puer/efan/EFan.kicad_pcb

## KiCad design EFan.kicad_pcb (2019-11-07)

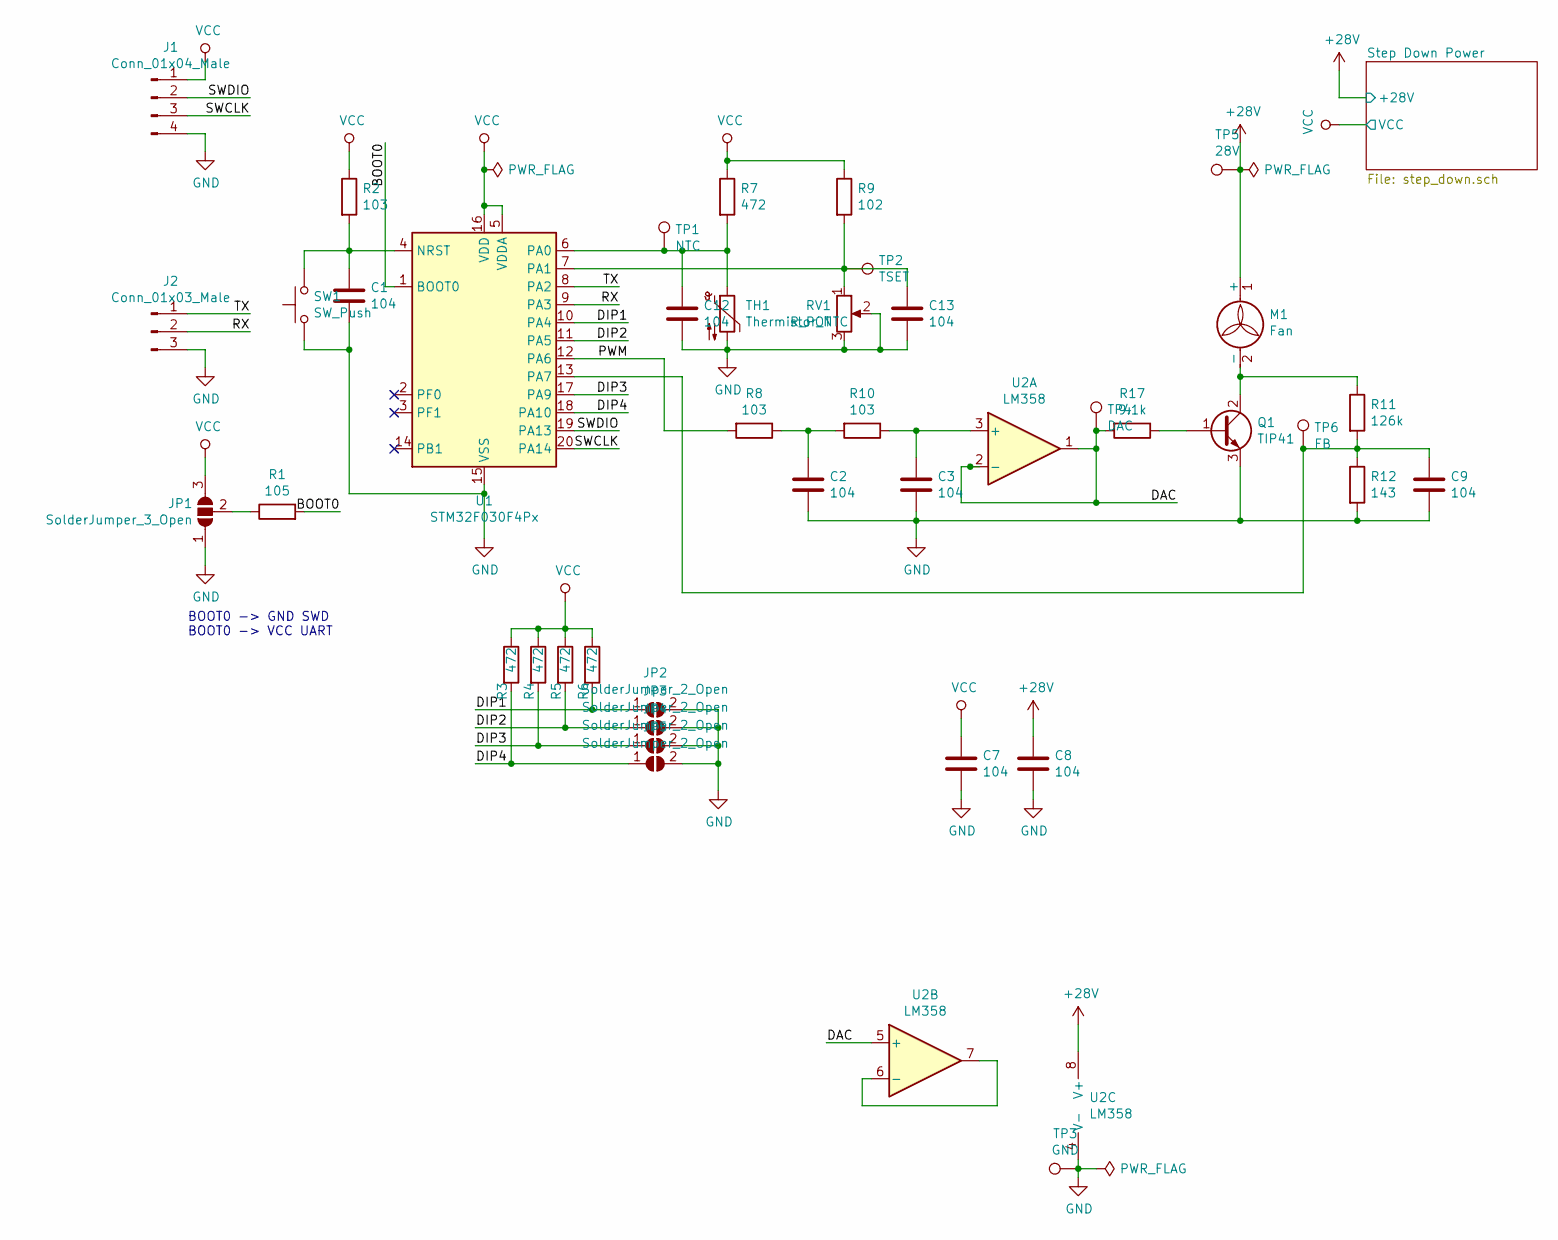
[picture p1: schematic EFan.sch]

Parts:
C1, C2, C3, C7, C8, C9, C12, C13: 104; C_0603_1608Metric_Pad1.05x0.95mm_HandSolder
J1: Conn_01x04_Male; PinHeader_1x04_P2.54mm_Vertical
J2: Conn_01x03_Male; PinHeader_1x03_P2.54mm_Vertical
JP1: SolderJumper_3_Open; SolderJumper-3_P1.3mm_Open_RoundedPad1.0x1.5mm_NumberLabels
JP2, JP3, JP4, JP5: SolderJumper_2_Open; SolderJumper-2_P1.3mm_Open_RoundedPad1.0x1.5mm
M1: Fan; PinHeader_1x02_P2.54mm_Vertical
Q1: TIP41; TO-220-3_Vertical
R1: 105; R_0603_1608Metric_Pad1.05x0.95mm_HandSolder
R2, R8, R10: 103; R_0603_1608Metric_Pad1.05x0.95mm_HandSolder
R3, R4, R5, R6, R7: 472; R_0603_1608Metric_Pad1.05x0.95mm_HandSolder
R9: 102; R_0603_1608Metric_Pad1.05x0.95mm_HandSolder
R11: 126k; R_0603_1608Metric_Pad1.05x0.95mm_HandSolder
R12: 143; R_0603_1608Metric_Pad1.05x0.95mm_HandSolder
R17: 9.1k; R_0603_1608Metric_Pad1.05x0.95mm_HandSolder
RV1: R_POT; Potentiometer_Bourns_3296W_Vertical
SW1: SW_Push; SW_PUSH_6mm
TH1: Thermistor_NTC; PinHeader_1x02_P2.54mm_Vertical
TP1: NTC; TestPoint_Loop_D2.50mm_Drill1.0mm
TP2: TSET; TestPoint_Loop_D2.50mm_Drill1.0mm
TP3: GND; PinHeader_1x01_P2.54mm_Vertical
TP4: DAC; TestPoint_Loop_D2.50mm_Drill1.0mm
TP5: 28V; PinHeader_1x01_P2.54mm_Vertical
TP6: FB; TestPoint_Loop_D2.50mm_Drill1.0mm
U1: STM32F030F4Px; TSSOP-20_4.4x6.5mm_P0.65mm
U2: LM358; DIP-8_W7.62mm

Connections:
+28V: C8.1, M1.1 (+), TP5.1, U2.8 (V+); also elsewhere on the board
/BOOT0: R1.2, U1.1 (BOOT0)
/DAC: R17.2, TP4.1, U2.1, U2.2 (-), U2.5 (+)
/DIP1: JP2.1 (A), R6.2, U1.10 (PA4)
/DIP2: JP3.1 (A), R5.2, U1.11 (PA5)
/DIP3: JP4.1 (A), R4.2, U1.17 (PA9)
/DIP4: JP5.1 (A), R3.2, U1.18 (PA10)
/PWM: R8.2, U1.12 (PA6)
/RX: J2.2, U1.9 (PA3)
/SWCLK: J1.3, U1.20 (PA14)
/SWDIO: J1.2, U1.19 (PA13)
/TX: J2.1, U1.8 (PA2)
GND: C1.2, C2.2, C3.2, C7.2, C8.2, C9.2, C12.2, C13.2, J1.4, J2.3, JP1.1 (A), JP2.2 (B), JP3.2 (B), JP4.2 (B), JP5.2 (B), Q1.3 (E), R12.2, RV1.2, RV1.3, SW1.1, TH1.2, TP3.1, U1.15 (VSS), U2.4 (V-); also elsewhere on the board
unnamed: C1.1, R2.2, SW1.2, U1.4 (NRST)
unnamed: C2.1, R8.1, R10.2
unnamed: C3.1, R10.1, U2.3 (+)
unnamed: C9.1, R11.2, R12.1, TP6.1, U1.13 (PA7)
unnamed: C12.1, R7.2, TH1.1, TP1.1, U1.6 (PA0)
unnamed: C13.1, R9.2, RV1.1, TP2.1, U1.7 (PA1)
unnamed: JP1.2 (C), R1.1
unnamed: M1.2 (-), Q1.2 (C), R11.1
unnamed: Q1.1 (B), R17.1
unnamed: U2.6 (-), U2.7
VCC: C7.1, J1.1, JP1.3 (B), R2.1, R3.1, R4.1, R5.1, R6.1, R7.1, R9.1, U1.5 (VDDA), U1.16 (VDD); also elsewhere on the board

Notes on the sheet:
BOOT0 -> GND SWD BOOT0 -> VCC UART

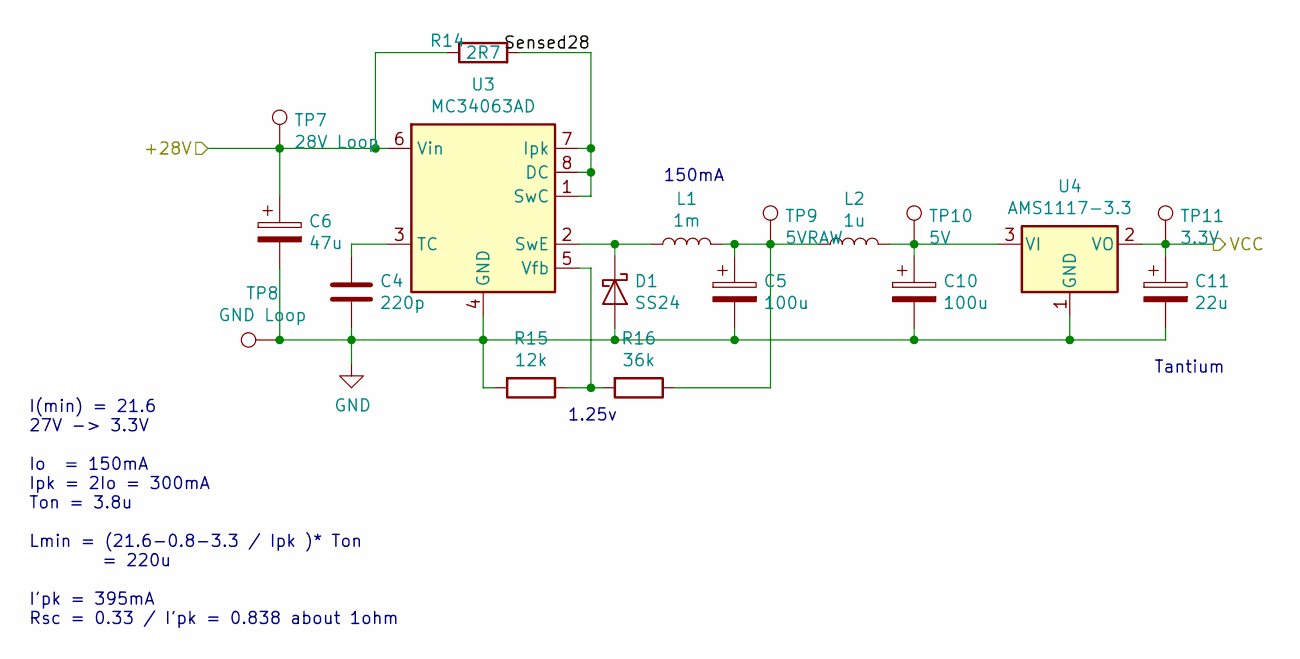
[picture p2: schematic step_down.sch]

Parts:
C4: 220p; C_0603_1608Metric_Pad1.05x0.95mm_HandSolder
C5, C10: 100u; C_Radial_D5.0mm_H7.0mm_P2.00mm
C6: 47u; CP_Elec_6.3x5.4
C11: 22u; CP_EIA-3216-18_Kemet-A_Pad1.58x1.35mm_HandSolder
D1: SS24; D_SMA_Handsoldering
L1: 1m; L_Radial_D7.0mm_P3.00mm
L2: 1u; L_0805_2012Metric_Pad1.15x1.40mm_HandSolder
R14: 2R7; R_0603_1608Metric_Pad1.05x0.95mm_HandSolder
R15: 12k; R_0603_1608Metric_Pad1.05x0.95mm_HandSolder
R16: 36k; R_0603_1608Metric_Pad1.05x0.95mm_HandSolder
TP7: 28V Loop; TestPoint_Loop_D2.50mm_Drill1.0mm
TP8: GND Loop; TestPoint_Loop_D2.50mm_Drill1.0mm
TP9: 5VRAW; TestPoint_Loop_D2.50mm_Drill1.0mm
TP10: 5V; TestPoint_Loop_D2.50mm_Drill1.0mm
TP11: 3.3V; TestPoint_Loop_D2.50mm_Drill1.0mm
U3: MC34063AD; SOIC-8_3.9x4.9mm_P1.27mm
U4: AMS1117-3.3; SOT-223-3_TabPin2

Connections:
+28V: C6.1, R14.1, TP7.1, U3.6 (Vin); also elsewhere on the board
/Step Down Power/Sensed28: R14.2, U3.1 (SwC), U3.7 (Ipk), U3.8 (DC)
GND: C4.2, C5.2, C6.2, C10.2, C11.2, D1.2 (A), R15.2, TP8.1, U3.4 (GND), U4.1 (GND); also elsewhere on the board
unnamed: C4.1, U3.3 (TC)
unnamed: C5.1, L1.2, L2.1, R16.1, TP9.1
unnamed: C10.1, L2.2, TP10.1, U4.3 (VI)
unnamed: D1.1 (K), L1.1, U3.2 (SwE)
unnamed: R15.1, R16.2, U3.5 (Vfb)
VCC: C11.1, TP11.1, U4.2 (VO); also elsewhere on the board

Notes on the sheet:
I(min) = 21.6 27V -> 3.3V Io = 150mA Ipk = 2Io = 300mA Ton = 3.8u Lmin = (21.6-0.8-3.3 / Ipk )* Ton = 220u I'pk = 395mA Rsc = 0.33 / I'pk = 0.838 about 1ohm
150mA
1.25v
Tantium

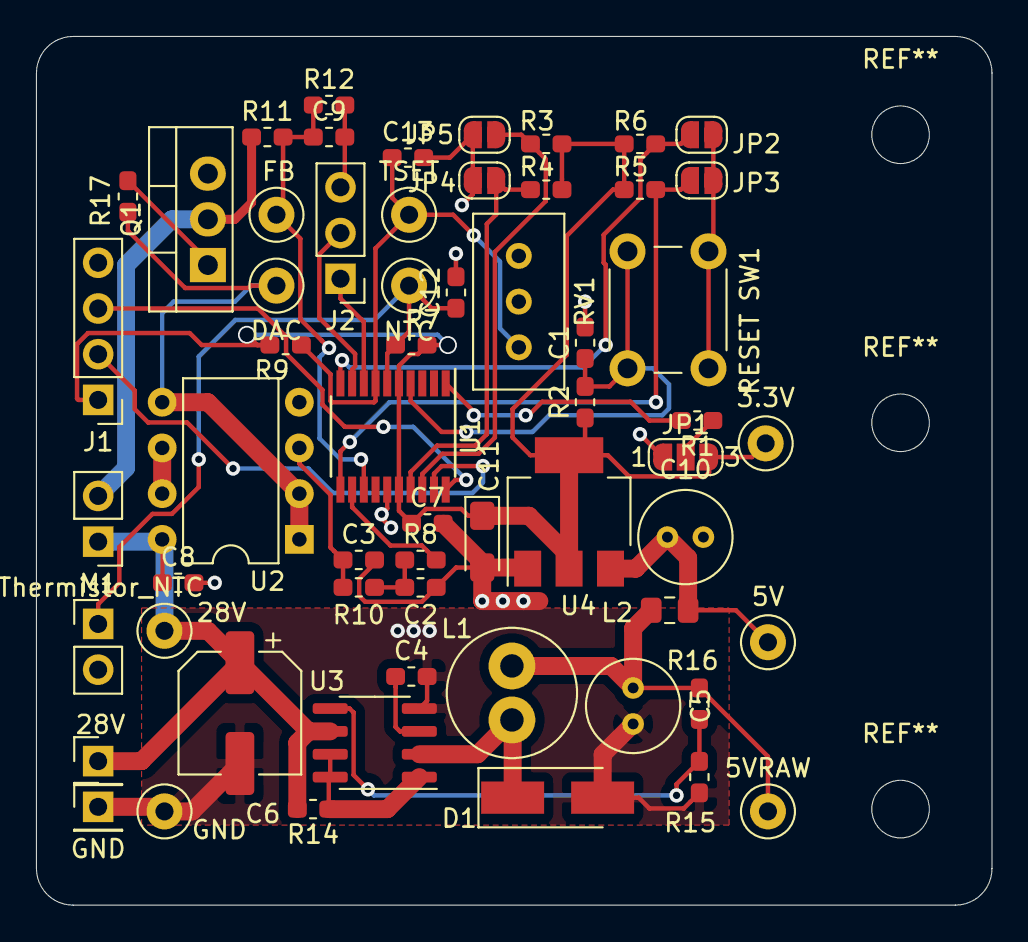
[picture p3: board EFan.kicad_pcb from above]

Board: 2 copper layers, 53.1 x 48.3 mm, 59 parts (0 on the bottom side), 30 nets.
