puer/efan/EFan/Src/main.c

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

/* Includes ------------------------------------------------------------------*/
#include "main.h"

ADC_HandleTypeDef hadc;
DMA_HandleTypeDef hdma_adc;

TIM_HandleTypeDef htim3;
TIM_HandleTypeDef htim14;

UART_HandleTypeDef huart1;
DMA_HandleTypeDef hdma_usart1_rx;
DMA_HandleTypeDef hdma_usart1_tx;

/* USER CODE BEGIN PV */
uint16_t temperature[2];
/* USER CODE END PV */

void SystemClock_Config(void);
static void MX_GPIO_Init(void);
static void MX_DMA_Init(void);
static void MX_ADC_Init(void);
static void MX_USART1_UART_Init(void);
static void MX_TIM3_Init(void);
static void MX_TIM14_Init(void);
/**
  * @brief  The application entry point.
  * @retval int
  */
int main(void)
{
  /* MCU Configuration--------------------------------------------------------*/

  /* Reset of all peripherals, Initializes the Flash interface and the Systick. */
  HAL_Init();

  /* Configure the system clock */
  SystemClock_Config();

  /* Initialize all configured peripherals */
  MX_GPIO_Init();
  MX_DMA_Init();
  MX_ADC_Init();
  MX_USART1_UART_Init();
  MX_TIM3_Init();
  MX_TIM14_Init();
  /* USER CODE BEGIN 2 */

  if (HAL_ADCEx_Calibration_Start(&hadc) != HAL_OK)
  {
    Error_Handler();
  }
  if (HAL_ADC_Start_DMA(&hadc, (uint32_t *)temperature, sizeof(uint16_t) * 2) != HAL_OK)
  {
    Error_Handler();
  }
  /* USER CODE END 2 */

  /* Infinite loop */
  /* USER CODE BEGIN WHILE */
  while (1)
  {
    /* USER CODE END WHILE */

    /* USER CODE BEGIN 3 */
  }
  /* USER CODE END 3 */
}

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
/* USER CODE BEGIN 4 */
const uint16_t SLOW_HALT = 300;
const uint16_t LINEAR_TEMP = 300;
void HAL_ADC_ConvCpltCallback(ADC_HandleTypeDef *h)
{
  if (&hadc == h)
  {
    uint16_t target = temperature[1];
    uint16_t current = temperature[0];
    static uint16_t previous = 0;
    TIM_OC_InitTypeDef sConfigOC = {0};

    if (current - SLOW_HALT < target)
    {
      // stop the pwm
      HAL_TIM_PWM_Stop(&htim3, TIM_CHANNEL_1);
      return;
    }

    HAL_TIM_PWM_GetState(&htim3);

    // filter small bumper
    if (current > previous)
    {
      if (current - previous < 10)
      {
        return;
      }
    }
    else
    {
      if (previous - current < 10)
      {
        return;
      }
    }
    if (current > target)
    {
      uint16_t p = (current - target) * 70 / LINEAR_TEMP;
      if (p > 70)
        p = 70;
      p += 30;
      p *= 4;

      htim3.Instance->CCR1 = p;

      previous = current;
    }
  }
}
/* USER CODE END 4 */
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
