puer/efan/EFan/EFan.ioc

Mcu.UserName=STM32F030F4Px
PA0.Signal=ADC_IN0
PA1.Signal=ADC_IN1
PA13.Signal=SYS_SWDIO
PA14.Signal=SYS_SWCLK
PA2.Signal=USART1_TX
PA3.Signal=USART1_RX
PA6.Signal=S_TIM3_CH1
PA7.Signal=S_TIM3_CH2
