puer/efan/(commit log)

2019-11-01 refine pcb
    [EFan.kicad_pcb]
2019-11-02 production 2
    [EFan.kicad_pcb, EFan.sch, step_down.sch]
2019-11-03 incr r9, to limit current usage
    [EFan.kicad_pcb, EFan.sch]
2019-11-07 add 2 coupling caps in adc input
    [EFan.kicad_pcb, EFan.sch, step_down.sch]
